MKonos/OBD-Smart-Dash/pictures/2.PNG

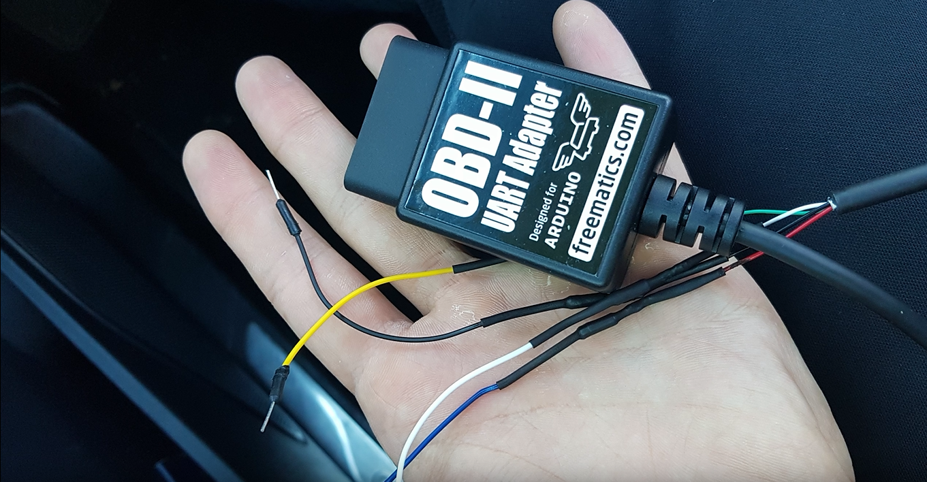
pictures/2.PNG
