MKonos/OBD-Smart-Dash/pictures/3.PNG

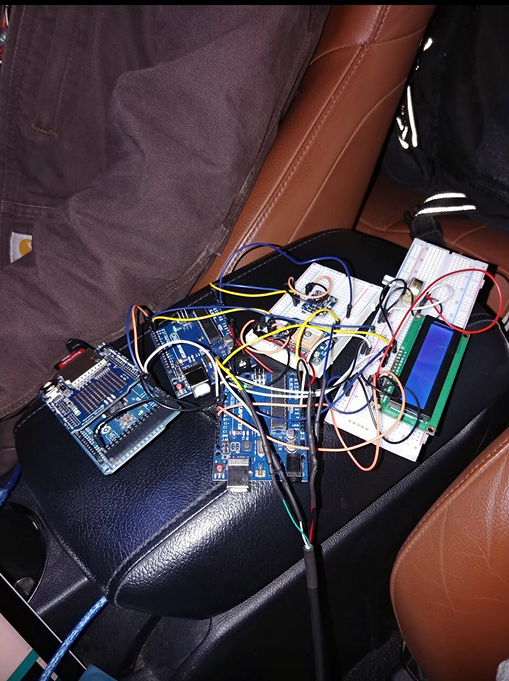
pictures/3.PNG
