MKonos/OBD-Smart-Dash/pictures/20171129_140109.jpg

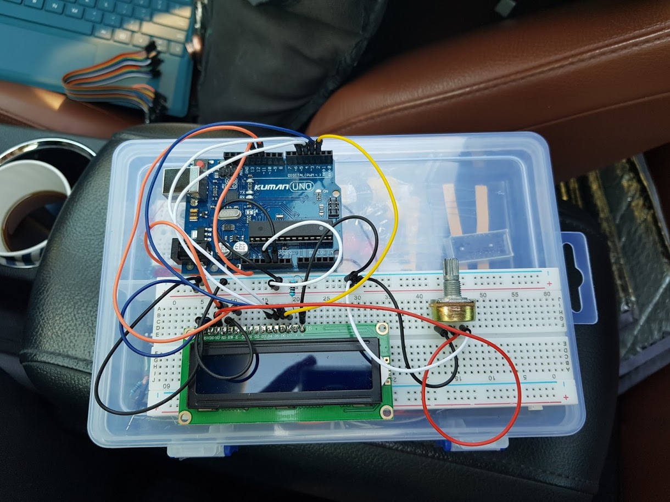
pictures/20171129_140109.jpg
